Guilherme-Viegas/Real-Time-Cooperative-Decentralised-Control-of-Illuminance-Systems/PI Controller (Individual Labs)/Labs_Rosa/Part1/Get_params/get_tau/tau_plot.png

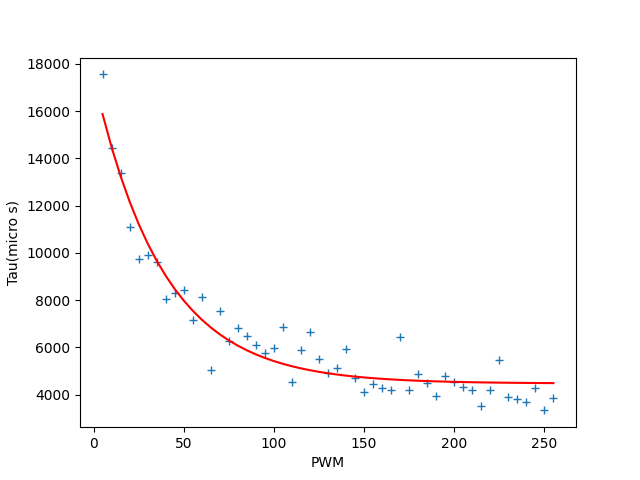
PI Controller (Individual Labs)/Labs_Rosa/Part1/Get_params/get_tau/tau_plot.png
