Guilherme-Viegas/Real-Time-Cooperative-Decentralised-Control-of-Illuminance-Systems/PI Controller (Individual Labs)/Labs_Viegas/STAGE_1_SCDTR/get_controller_params/plots/lab2/dead_time.png

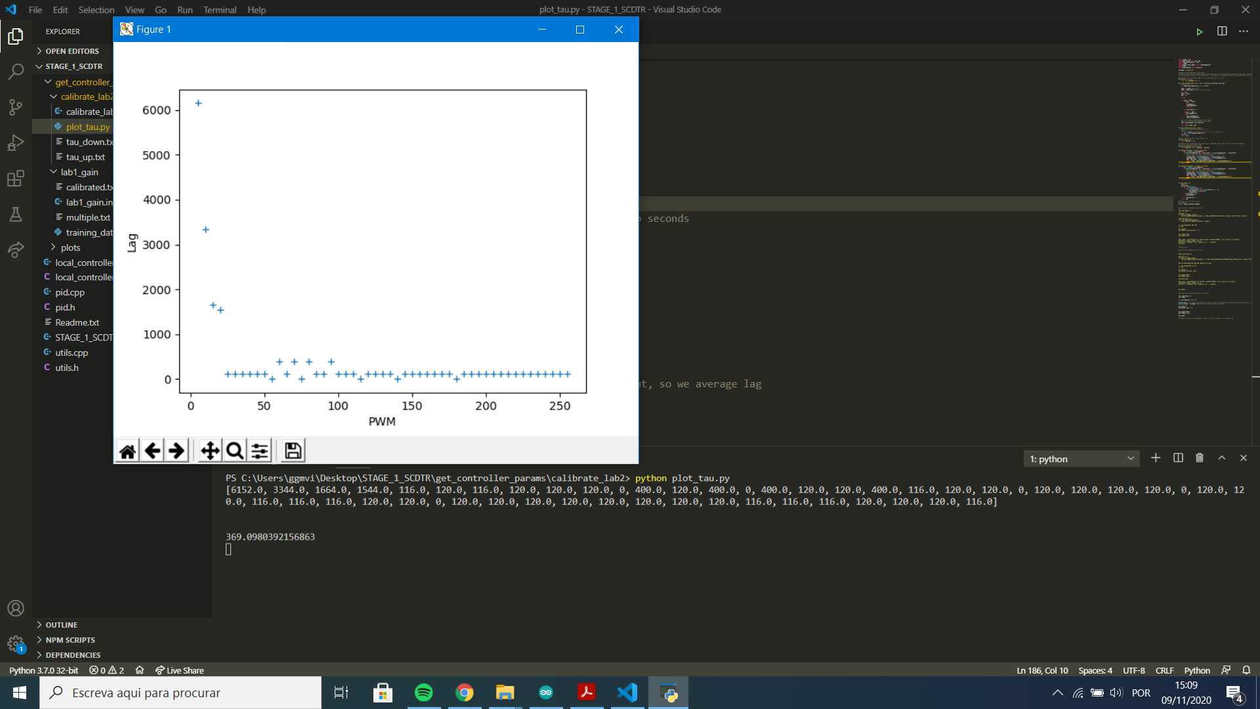
PI Controller (Individual Labs)/Labs_Viegas/STAGE_1_SCDTR/get_controller_params/plots/lab2/dead_time.png
