Guilherme-Viegas/Real-Time-Cooperative-Decentralised-Control-of-Illuminance-Systems/PI Controller (Individual Labs)/Labs_Viegas/STAGE_1_SCDTR_01/constants_pics/p0.5_i0.3.png

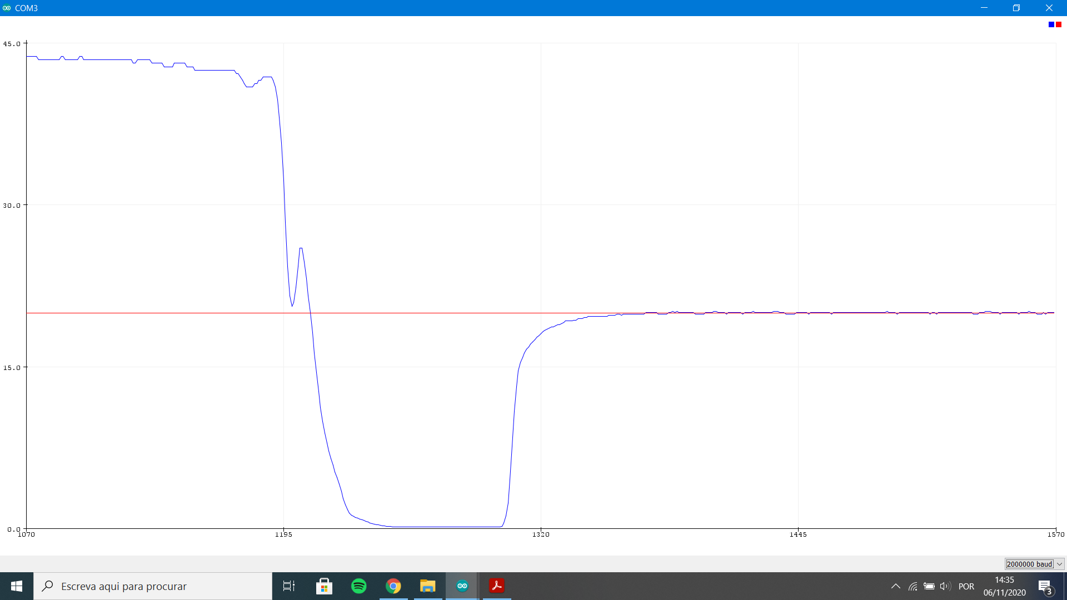
PI Controller (Individual Labs)/Labs_Viegas/STAGE_1_SCDTR_01/constants_pics/p0.5_i0.3.png
