Guilherme-Viegas/Real-Time-Cooperative-Decentralised-Control-of-Illuminance-Systems/PI Controller (Individual Labs)/Labs_Almeida/ldr_fit/text_files/negative_step_response.txt

1000
PWM	0	5.33
0	68.14
1	68.14
2	66.07
3	61.04
4	55.14
5	48.78
6	43.26
7	38.22
8	33.83
9	29.82
10	26.73
11	23.84
12	21.26
13	19.16
14	17.16
15	15.53
16	14.03
17	12.66
18	11.46
19	10.43
20	9.52
21	8.68
22	7.95
23	7.26
24	6.70
25	6.13
26	5.64
27	5.20
PWM	1	5.68
0	68.14
1	67.72
2	64.87
3	59.23
4	52.92
5	46.85
6	41.34
7	36.56
8	32.55
9	28.86
10	25.73
11	23.08
12	20.69
13	18.64
14	16.79
15	15.18
16	13.79
17	12.51
18	11.40
19	10.43
20	9.52
21	8.74
22	8.00
23	7.35
24	6.74
25	6.22
26	5.76
27	5.36
PWM	2	6.15
0	68.14
1	68.14
2	66.07
3	61.41
4	55.14
5	49.06
6	43.50
7	38.65
8	34.21
9	30.48
10	27.17
11	24.37
12	21.85
13	19.70
14	17.84
15	16.15
16	14.60
17	13.40
18	12.15
19	11.07
20	10.18
21	9.35
22	8.57
23	7.89
24	7.26
25	6.70
26	6.26
27	5.76
PWM	3	6.62
0	68.14
1	68.14
2	66.07
3	61.41
4	55.47
5	49.34
6	43.75
7	38.65
8	34.40
9	30.65
10	27.32
11	24.50
12	21.97
13	19.80
14	18.04
15	16.33
16	14.84
17	13.48
18	12.37
19	11.33
20	10.37
21	9.52
22	8.84
23	8.15
24	7.55
25	7.07
26	6.52
PWM	4	7.08
0	68.14
1	67.72
2	66.48
3	62.16
4	55.80
5	49.92
6	44.00
7	39.09
8	34.78
9	30.98
10	27.77
11	25.04
12	22.46
13	20.35
14	18.34
15	16.69
16	15.18
17	13.87
18	12.66
19	11.67
20	10.74
21	9.88
22	9.12
23	8.47
24	7.84
25	7.30
26	6.79
PWM	5	7.53
0	68.14
1	68.14
2	66.89
3	62.54
4	56.47
5	50.21
6	44.76
7	39.75
8	35.36
9	31.67
10	28.23
11	25.32
12	22.83
13	20.69
14	18.75
15	17.07
16	15.61
17	14.27
18	13.10
19	12.01
20	11.07
21	10.24
22	9.47
23	8.79
24	8.20
25	7.60
26	7.11
PWM	6	8.00
0	68.14
1	68.14
2	66.48
3	61.78
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
1	68.14
2	68.14
3	68.14
4	67.72
5	67.72
6	67.31
7	67.31
8	66.89
9	66.89
10	66.48
PWM	245	66.57
0	68.14
1	68.14
2	68.14
3	68.14
4	67.72
5	67.72
6	67.31
7	67.31
8	67.31
9	66.89
10	66.89
11	66.48
PWM	246	66.83
0	68.14
1	68.14
2	68.14
3	67.31
4	67.72
5	67.72
6	67.31
7	67.31
8	66.89
9	66.89
10	66.89
11	66.89
12	66.48
PWM	247	66.83
0	68.14
1	68.14
2	68.14
3	68.14
4	68.14
5	67.72
6	67.72
7	67.31
8	66.89
9	66.07
PWM	248	67.09
0	68.14
1	68.14
2	68.14
3	67.72
4	68.14
5	67.72
6	67.72
7	67.72
8	67.31
9	66.89
PWM	249	67.35
0	68.14
1	68.14
2	68.14
3	67.72
4	67.72
5	67.72
6	67.72
7	67.31
PWM	250	67.35
0	68.14
1	68.14
2	68.14
3	67.72
4	67.72
5	67.72
6	67.72
7	67.72
8	67.72
9	67.31
PWM	251	67.61
0	68.14
1	68.14
2	67.72
3	67.72
4	67.72
5	67.72
6	67.72
7	67.31
PWM	252	67.61
0	68.14
1	68.14
2	67.72
3	68.14
4	67.72
5	67.72
6	67.72
7	67.72
8	67.72
9	67.72
10	67.72
11	67.72
12	67.72
13	67.31
PWM	253	67.88
0	68.14
1	68.14
2	68.14
3	67.72
PWM	254	67.88
0	68.14
1	68.14
2	68.14
3	68.14
4	68.14
5	68.14
6	68.14
7	68.14
8	68.14
9	68.14
10	68.14
11	68.14
12	67.72
