Guilherme-Viegas/Real-Time-Cooperative-Decentralised-Control-of-Illuminance-Systems/PI Controller (Individual Labs)/Labs_Almeida/ldr_fit/text_files/positive_step_response.txt

1000
PWM	1	0.02
0	0.00
1	0.00
2	0.00
3	0.00
4	0.00
5	0.00
6	0.00
7	0.00
8	0.00
9	0.00
10	0.00
11	0.00
12	0.00
13	0.00
14	0.00
15	0.00
16	0.00
17	0.00
18	0.00
19	0.01
20	0.01
21	0.01
22	0.01
23	0.01
24	0.01
25	0.01
26	0.01
27	0.01
28	0.01
29	0.02
30	0.02
31	0.02
32	0.02
33	0.02
34	0.02
35	0.02
36	0.02
37	0.02
38	0.02
39	0.02
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
PWM	2	0.10
0	0.00
1	0.00
2	0.00
3	0.00
4	0.00
5	0.00
6	0.00
7	0.00
8	0.00
9	0.00
10	0.00
11	0.01
12	0.01
13	0.01
14	0.01
15	0.02
16	0.02
17	0.02
18	0.02
19	0.02
20	0.02
21	0.03
22	0.03
23	0.03
24	0.04
25	0.03
26	0.04
27	0.04
28	0.05
29	0.05
30	0.05
31	0.05
32	0.06
33	0.06
34	0.06
35	0.06
36	0.07
37	0.07
38	0.08
39	0.08
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
PWM	3	0.19
0	0.00
1	0.00
2	0.00
3	0.00
4	0.00
5	0.00
6	0.00
7	0.00
8	0.00
9	0.00
10	0.01
11	0.01
12	0.02
13	0.02
14	0.02
15	0.02
16	0.03
17	0.03
18	0.04
19	0.04
20	0.05
21	0.05
22	0.05
23	0.06
24	0.06
25	0.07
26	0.08
27	0.08
28	0.08
29	0.09
30	0.10
31	0.10
32	0.11
33	0.11
34	0.12
35	0.13
36	0.14
37	0.14
38	0.15
39	0.15
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
PWM	4	0.29
0	0.00
1	0.00
2	0.00
3	0.00
4	0.00
5	0.00
6	0.00
7	0.00
8	0.00
9	0.01
10	0.02
11	0.02
12	0.02
13	0.02
14	0.03
15	0.04
16	0.05
17	0.05
18	0.06
19	0.06
20	0.07
21	0.08
22	0.08
23	0.09
24	0.10
25	0.11
26	0.11
27	0.13
28	0.13
29	0.15
30	0.15
31	0.17
32	0.18
33	0.19
34	0.19
35	0.21
36	0.21
37	0.22
38	0.23
39	0.24
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
PWM	5	0.39
0	0.00
1	0.00
2	0.00
3	0.00
4	0.00
5	0.00
6	0.00
7	0.01
8	0.01
9	0.02
10	0.02
11	0.03
12	0.03
13	0.05
14	0.05
15	0.06
16	0.07
17	0.08
18	0.10
19	0.11
20	0.11
21	0.11
22	0.14
23	0.14
24	0.16
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
3	0.11
4	0.49
5	1.26
6	2.41
7	4.00
8	5.96
9	8.31
10	11.00
11	13.95
12	17.07
PWM	254	16.21
0	0.00
1	0.00
2	0.01
3	0.14
4	0.58
5	1.41
6	2.64
7	4.27
8	6.35
9	8.74
10	11.40
11	14.43
12	17.64
PWM	255	16.27
0	0.00
1	0.00
2	0.02
3	0.20
4	0.71
5	1.63
6	2.96
7	4.69
8	6.79
9	9.29
10	12.08
11	15.18
12	18.44
