Guilherme-Viegas/Real-Time-Cooperative-Decentralised-Control-of-Illuminance-Systems/PI Controller (Individual Labs)/Labs_Almeida/ldr_fit/text_files/calibrated.txt

0	0.02
1	0.07
2	0.18
3	0.33
4	0.48
5	0.68
6	0.89
7	1.10
8	1.31
9	1.55
10	1.77
11	2.01
12	2.24
13	2.49
14	2.74
15	3.04
16	3.27
17	3.56
18	3.81
19	4.10
20	4.37
21	4.62
22	4.87
23	5.09
24	5.44
25	5.76
26	6.05
27	6.35
28	6.61
29	6.88
30	7.16
31	7.40
32	7.69
33	8.00
34	8.31
35	8.63
36	8.90
37	9.18
38	9.41
39	9.70
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
