Guilherme-Viegas/Real-Time-Cooperative-Decentralised-Control-of-Illuminance-Systems/PI Controller (Individual Labs)/Labs_Viegas/STAGE_1_SCDTR_01/get_controller_params/calibrated.txt

0 0.00
1 0.00
2 0.02
3 0.05
4 0.10
5 0.16
6 0.23
7 0.31
8 0.39
9 0.46
10 0.55
11 0.63
12 0.71
13 0.79
14 0.85
15 0.95
16 1.04
17 1.11
18 1.20
19 1.28
20 1.34
21 1.44
22 1.52
23 1.58
24 1.67
25 1.76
26 1.81
27 1.90
28 1.99
29 2.04
30 2.12
31 2.22
32 2.26
33 2.35
34 2.44
35 2.47
36 2.57
37 2.65
38 2.69
39 2.77
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
