Guilherme-Viegas/Real-Time-Cooperative-Decentralised-Control-of-Illuminance-Systems/Full Project/PC Application/server_code/server.cpp

#include "serial.hpp"
#include "async_server.hpp"

#include <thread>

#define PORT 18700 // https://stackoverflow.com/questions/3855127/find-and-kill-process-locking-port-3000-on-mac

#define INIT_COMMAND "+RPiS"
#define TIME_TO_SHUT_DOWN 0
#define NUM_THREADS 4

// global variable to control whether the server runs or not
boost::asio::io_context io;

// times to close the program
void start_timer(boost::asio::steady_timer *timer)
{
    if (!TIME_TO_SHUT_DOWN)
    {
        return;
    } // disable
    timer->expires_after(boost::asio::chrono::seconds{TIME_TO_SHUT_DOWN});
    timer->async_wait([](const boost::system::error_code &t_ec) {
        io.stop();
    });
}

void safety_exit( int sig )
{
        std::cout << "\t Safely close the client with signal: " << sig << std::endl;
        io.stop();  
}

int main()
{
    // close server after x seconds
    boost::asio::steady_timer timer{io};
    start_timer(&timer);

    std::signal(SIGABRT, safety_exit);
    std::signal(SIGFPE, safety_exit);
    std::signal(SIGILL, safety_exit);
    std::signal(SIGINT, safety_exit);
    std::signal(SIGSEGV, safety_exit);
    std::signal(SIGTERM, safety_exit);

    // init serial
    communications the_serial{&io};

    uint8_t num_lamps = the_serial.has_hub();
    if (num_lamps <= 0)
    {
        std::cout << "Early exit with" << (int)num_lamps << " lamps" << std::endl;
        return 0;
    }
    office the_office{num_lamps};

    tcp_server server_tcp{&io, PORT, &the_office, &the_serial};
    udp_server server_udp{&io, PORT + 1, &the_office};

    the_serial.write_command(INIT_COMMAND);
    the_serial.read_until_asynchronous(&the_office, '+');

    std::thread threads[NUM_THREADS];
    for (int i = 0; i < NUM_THREADS; i++)
    {
        threads[i] = std::thread{[]() { io.run(); }};
    }

    for (int i = 0; i < NUM_THREADS; i++)
    {
        threads[i].join();
    }

    if (NUM_THREADS == 0)
    {
        io.run();
    }

    return 0;
}
