Guilherme-Viegas/Real-Time-Cooperative-Decentralised-Control-of-Illuminance-Systems/PI Controller (Individual Labs)/Labs_Almeida/ldr_fit/ldr_fit.ino

#include "ldr_fit.h"

boolean LOOP = true;
boolean SIMULATOR = true;
int i = 0;
float m = -0.718;
void setup() {

  Serial.begin(2000000);
  delay(500);
  
  steps_up(m);
  steps_down(m);
}


void loop() {}
