Guilherme-Viegas/Real-Time-Cooperative-Decentralised-Control-of-Illuminance-Systems/Full Project/PC Application/server_code/serial.hpp

#ifndef SERIAL_HPP
#define SERIAL_HPP

// /*
// This file supports the communications throughout the server
// */

#include <iostream>
#include <string>
#include <boost/asio.hpp>

#include "database.hpp"

// Ports
#define RPI_PORT "/dev/ttyACM0"            // dmesg
#define MAC_PORT "/dev/tty.usbmodem143101" // ls /dev/tty.*
#define BAUD_RATE 230400                   //230400
#define ARDUINO_MESSAGE "Arduino"
#define BUFFER_SIZE_COMMAND 4
#define BUFFER_SIZE_STREAM 6

/*
 * Controls the Serial comunication
 */
class communications
{

private: // this things are private
    std::unique_ptr<boost::asio::serial_port> t_serial;

    boost::system::error_code t_ec;
    boost::asio::streambuf t_buf_command{BUFFER_SIZE_COMMAND};
    boost::asio::streambuf t_buf_stream{BUFFER_SIZE_STREAM};
    boost::asio::streambuf t_buf{1};
    bool t_coms_available = true;

    // functions
    void read_async_command(office *the_office);

public:                                          // this things are public
    communications(boost::asio::io_context *io); // constructor
    ~communications();                           // destructor

    uint8_t has_hub();
    void write_command(std::string command);
    void read_until_asynchronous(office *the_office, char delimiter);
    void set_coms_not_available() { t_coms_available = false; }
};

#endif

// boost::asio::serial_port sp{io};
// boost::asio::steady_timer tim{io};
// boost::asio::streambuf buf_1{1}; //read buffer
// boost::asio::streambuf buf_trash; //read buffer
