Guilherme-Viegas/Real-Time-Cooperative-Decentralised-Control-of-Illuminance-Systems/Full Project/Project/comms/Testes/STAGE_2_SCDTR_SLAVE/can_buffer.cpp

#include "can_buffer.h"

inline int can_frame_stream::sendMessage( can_frame &frame ) {
  if ( write_lock )
    return 0; //buffer full
  cf_buffer[ write_index ] = frame;
  write_index = ( ++write_index ) % buffsize;
  if ( write_index == read_index)
    write_lock = true; //cannot write more
  return 1;
}

inline int can_frame_stream::readMessage( can_frame &frame ) {
  if ( !write_lock && ( read_index == write_index ) )
    return 0; //empty buffer
  if ( write_lock && ( read_index == write_index ) )
    write_lock = false; //release lock
  frame = cf_buffer[ read_index ];
  read_index = ( ++read_index ) % buffsize;
  return 1;
}
