Guilherme-Viegas/Real-Time-Cooperative-Decentralised-Control-of-Illuminance-Systems/(commit log)

2020-10-12 divided by 0 error
    [training_data.py]
2020-10-26 Just missing v(t) plots, last side
    [training_data.cpp, training_data.h, training_data.py]
2020-10-28 Starting pid
2020-11-05 Works fine...only needs the ks calibration and some test...Finally things align together and work as expected...VERY NICE
2020-12-01 One code for all Arduinos... Node entering protocol done
2020-12-08 Minor fixes and starting coms with rpi
    [controller.ino, util.cpp, util.h]
2021-01-01 Consensus functions added, missing implementation on main
    [consensus.cpp, consensus.hpp, controller.ino, util.cpp, util.h]
2021-01-02 Consensus is done, missing testing and solidifying
    [consensus.cpp, consensus.hpp, controller.cpp, controller.ino, hub.cpp, ldr_controller.cpp, ldr_controller.h, util.cpp]
2021-01-03 minor fixes on consensus and bounds done
    [consensus.cpp, consensus.hpp, controller.cpp, controller.ino]
2021-01-03 Added some hub functionalities - missing testing
    [controller.ino]
2021-01-04 minor improvments, trying to fix canbus rx overflow
    [consensus.cpp, consensus.hpp, controller.ino]
2021-01-04 Fixes on hub messages
    [controller.ino]
2021-01-05 Finally hub messages are working ... Missing stream, reference and illuminance
    [async_server.cpp, async_server.hpp, controller.ino]
2021-01-07 Reset done, but with strange offset values... missing testing
    [controller.cpp, controller.h, controller.ino]
2021-01-07 added eeprom writings and minor fixes on controller
    [calibrate_lab2.ino, controller.ino, eeprom_put.ino]
2021-01-07 Qual é o cão que adivinha o futuro? É o cãoguru
